mew327/Micah-s-Audio-Transceiver/README.md

# Micah-s-Audio-Transceiver
Low Latency RF Transceiver
