mew327/Micah-s-Audio-Transceiver/Antenna_Candidate_1/CC2430DB_PCB_1_3/Inverted_F_Antenna.dxf

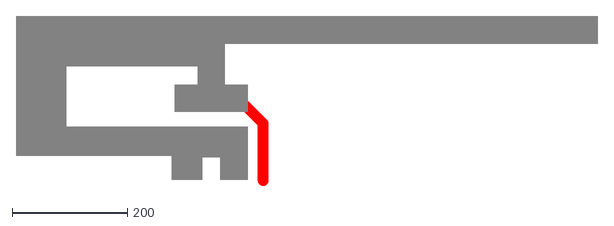
[picture p1: CAD file, 2026-10-24]
Antenna_Candidate_1/CC2430DB_PCB_1_3/Inverted_F_Antenna.dxf
1008.0 x 294.0
