mew327/Micah-s-Audio-Transceiver/Receiver_Enclosure_3d_Print/Receiver_Enclosure_Draft.3mf

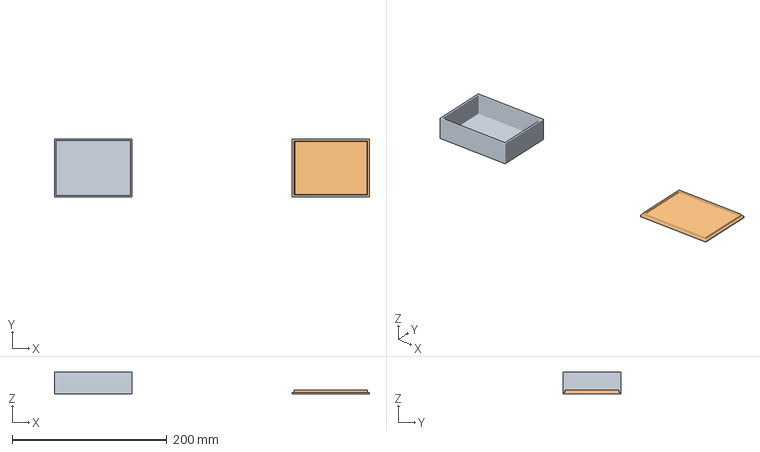
[picture p2: CAD file, 2026-10-24]
Receiver_Enclosure_3d_Print/Receiver_Enclosure_Draft.3mf
407.2 x 75.0 x 28.0 mm
receiver_base.stl
receiver_lid.stl
