mew327/Micah-s-Audio-Transceiver/Receiver_Enclosure_3d_Print/receiver_base.3mf

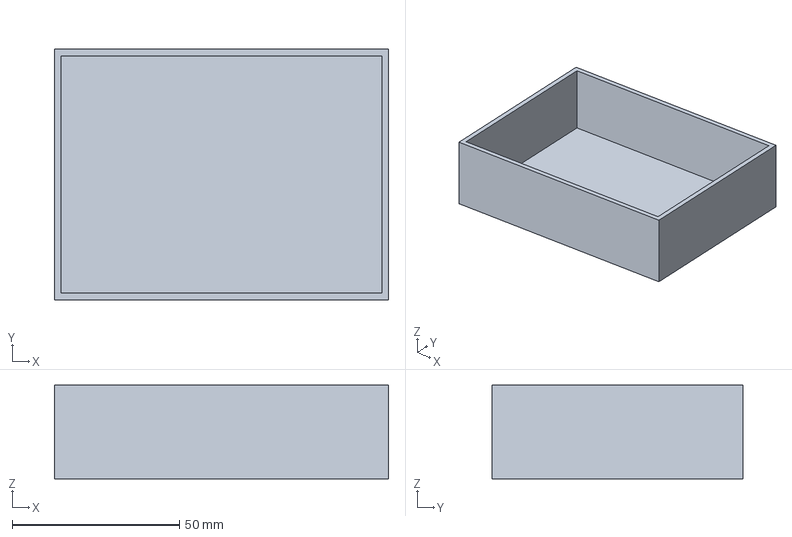
[picture p3: CAD file, 2026-10-24]
Receiver_Enclosure_3d_Print/receiver_base.3mf
100.0 x 75.0 x 28.0 mm
