mew327/Micah-s-Audio-Transceiver/(list of files, cad)

Other CAD files:
Receiver_Enclosure_3d_Print/receiver_base.stl
Receiver_Enclosure_3d_Print/receiver_lid.stl
