mew327/Micah-s-Audio-Transceiver/Guitar_Transceiver/Guitar_Receiver.kicad_pcb

## KiCad design Guitar_Transceiver/Guitar_Receiver.kicad_pcb (2026-11-04)

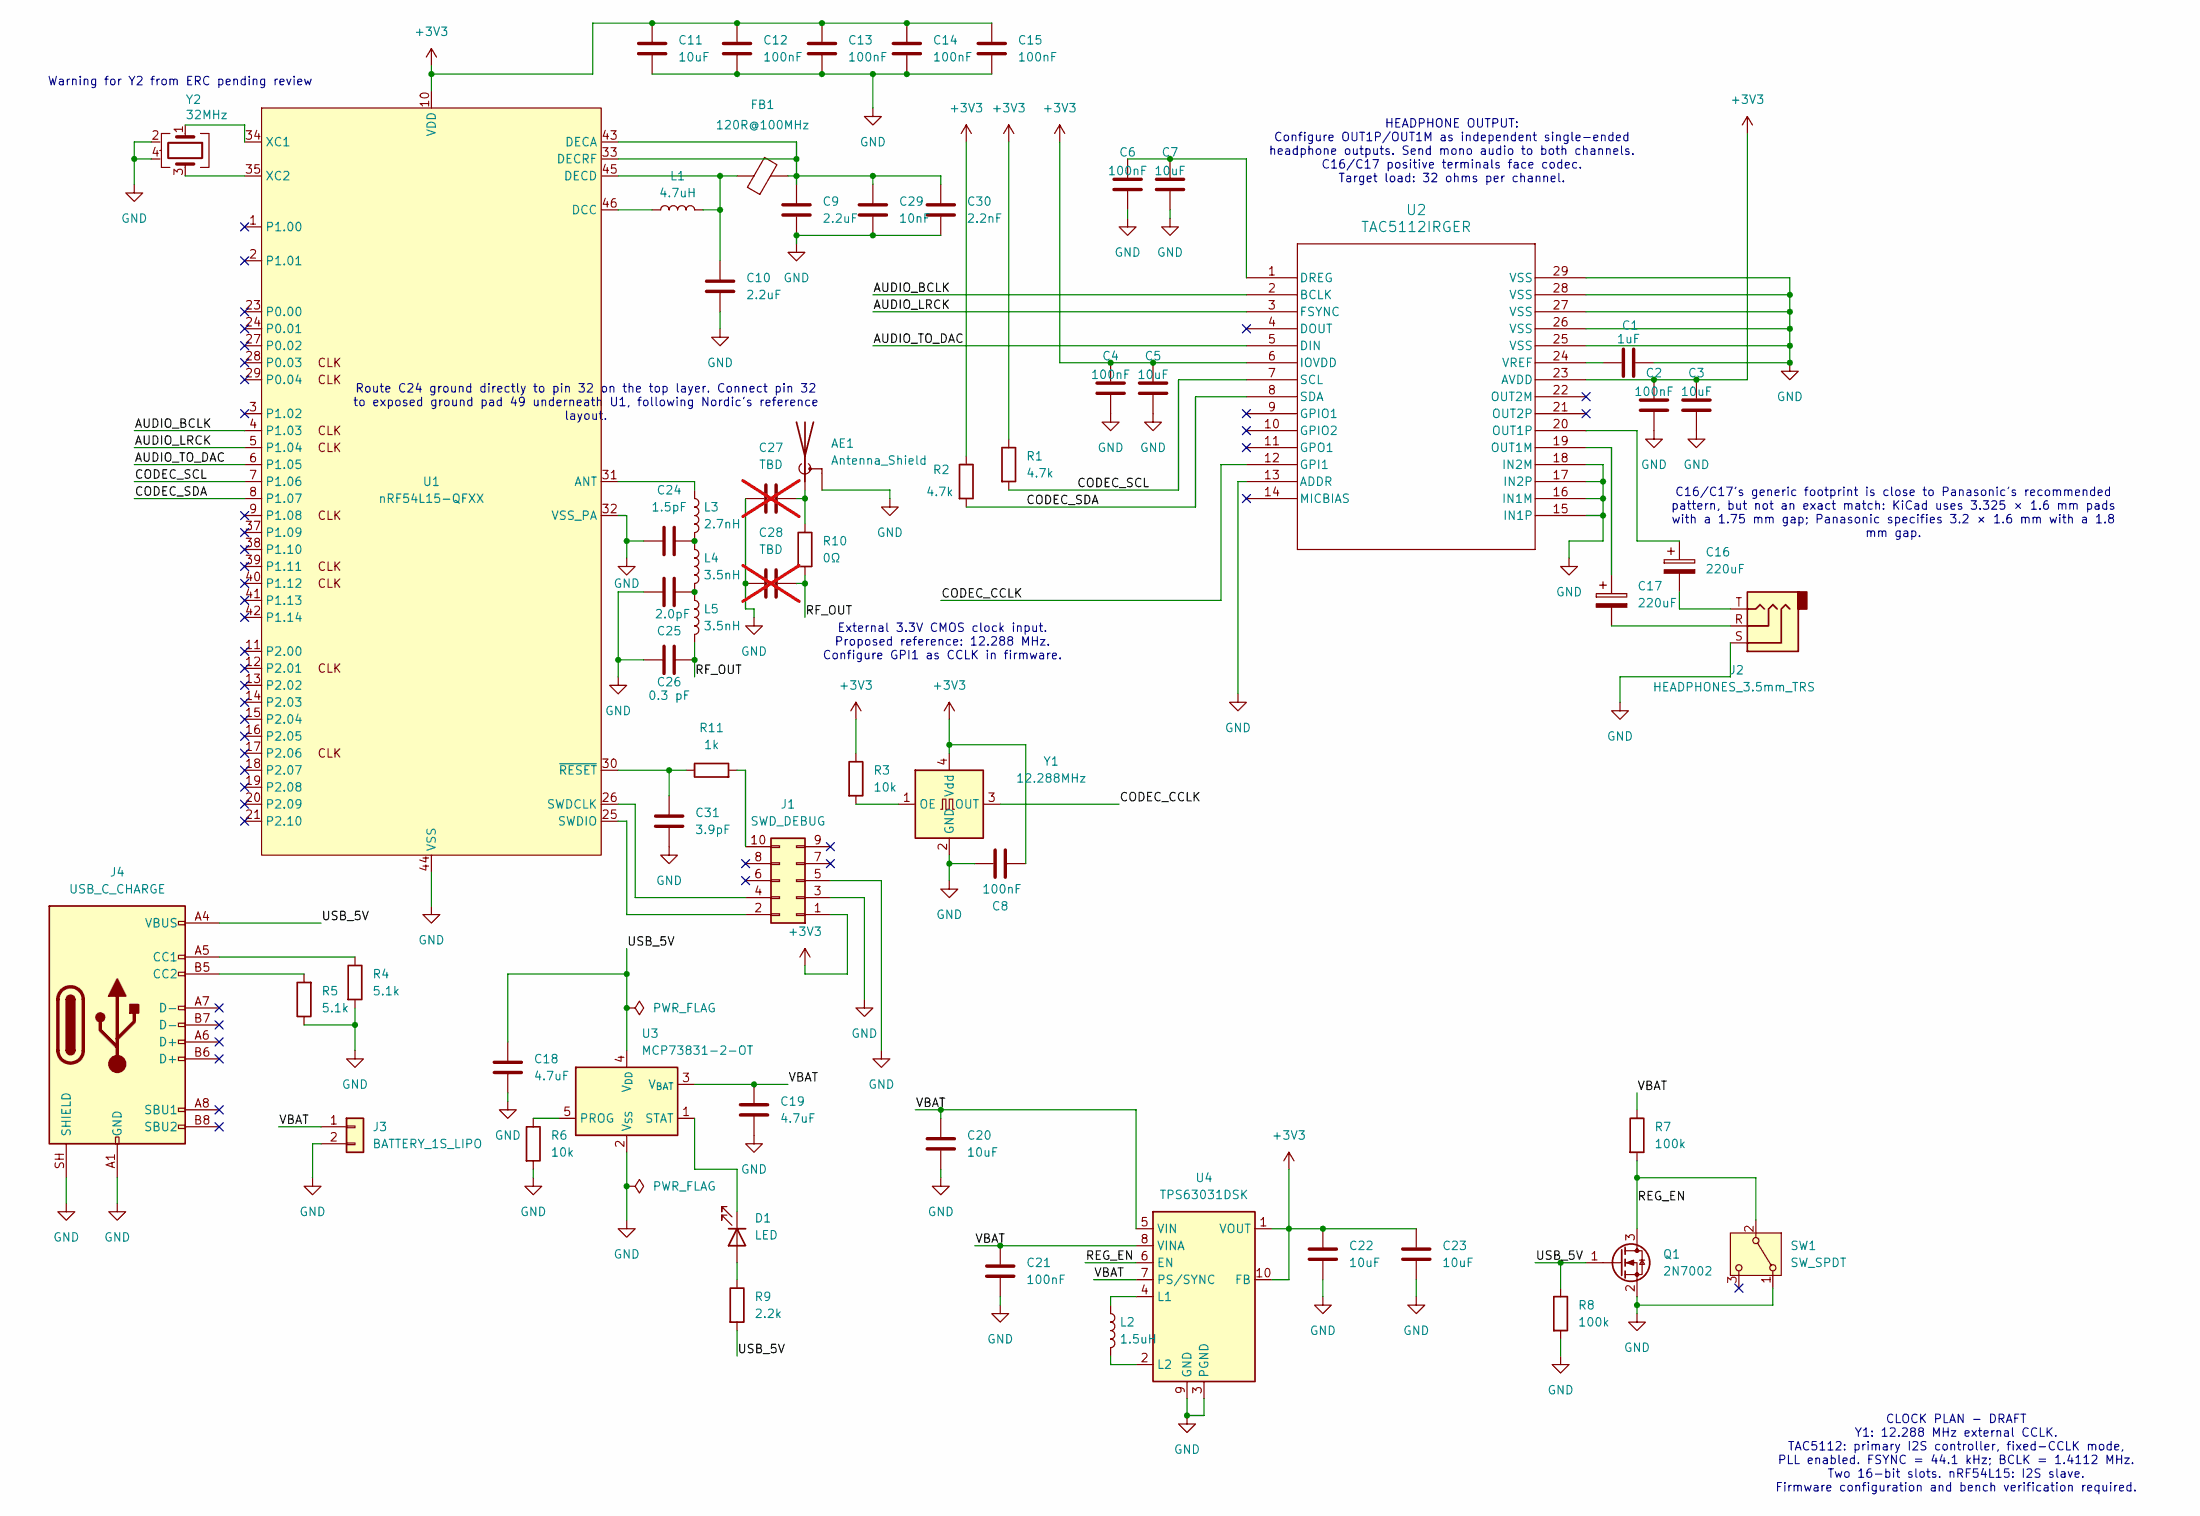
[picture p5: schematic Guitar_Receiver.kicad_sch]

Parts:
AE1: Antenna_Shield; IFA_SWRU120D_Copper_Draft
C1: 1uF; C_0603_1608Metric; Voltage Rating 10V
C2, C4, C6: 100nF; C_0603_1608Metric; Voltage Rating 10V
C3, C5, C7: 10uF; C_0805_2012Metric; Voltage Rating 10V
C8: 100nF; C_0603_1608Metric; Voltage Rating 10V; Tolerance ±10%
C9, C10: 2.2uF; C_0201_0603Metric; Voltage Rating 2.5V; Tolerance ±20%
C11: 10uF; C_0402_1005Metric; Voltage Rating 6.3V; Tolerance ±20%
C12, C13, C14, C15: 100nF; C_0201_0603Metric; Voltage Rating 6.3V; Tolerance ±10%
C16, C17: 220uF; C_Elec_6.3x5.8; Voltage Rating 6.3V; Tolerance ±20%; MPN EEEFP0J221AP
C18, C19: 4.7uF; C_0603_1608Metric; Voltage Rating 10V
C20, C22, C23: 10uF; C_0805_2012Metric; Voltage Rating 10 V
C21: 100nF; C_0603_1608Metric; Voltage Rating 10 V
C24: 1.5pF; C_0201_0603Metric; Tolerance ±0.05 pF; Voltage Rating ≥25 V
C25: 2.0pF; C_0201_0603Metric; Tolerance ±0.05 pF; Voltage Rating ≥25 V
C26: 0.3 pF; C_0201_0603Metric; Tolerance ±0.1 pF; Voltage Rating 50 V
C27, C28: TBD; C_0201_0603Metric; Voltage Rating ≥25 V; not fitted
C29: 10nF; C_0201_0603Metric; Tolerance ±10%; Voltage Rating ≥6.3 V
C30: 2.2nF; C_0201_0603Metric; Tolerance ±10%; Voltage Rating ≥10 V
C31: 3.9pF; C_0201_0603Metric; Tolerance ±0.25 pF; Voltage Rating 50 V
D1: LED; LED_0603_1608Metric; MPN APT1608SURCK
FB1: 120R@100MHz; L_0201_0603Metric; Current Rating 200 mA; MPN BLM03AG121SN1D
J1: SWD_DEBUG; PinHeader_2x05_P1.27mm_Vertical
J2: HEADPHONES_3.5mm_TRS; Jack_3.5mm_CUI_SJ1-3523N_Horizontal; MPN SJ1-3523N
J3: BATTERY_1S_LIPO; JST_PH_B2B-PH-K_1x02_P2.00mm_Vertical; MPN B2B-PH-K-S(LF)(SN)
J4: USB_C_CHARGE; USB_C_Receptacle_GCT_USB4105-xx-A_16P_TopMnt_Horizontal; MPN USB4105-GF-A
L1: 4.7uH; L_0603_1608Metric; Tolerance ±20%; Current Rating >120 mA
L2: 1.5uH; L_Coilcraft_LPS3015_3.0x3.0mm; Tolerance ±20%; MPN LPS3015-152MRC
L3: 2.7nH; L_0201_0603Metric; Tolerance ±0.1 nH; Current Rating ≥600 mA
L4, L5: 3.5nH; L_0201_0603Metric; Tolerance ±0.1 nH; Current Rating ≥500 mA
Q1: 2N7002; SOT-23
R1, R2: 4.7k; R_0603_1608Metric
R3, R6: 10k; R_0603_1608Metric
R4, R5: 5.1k; R_0603_1608Metric; Tolerance ±1%
R7, R8: 100k; R_0603_1608Metric
R9: 2.2k; R_0603_1608Metric
R10: 0Ω; R_0201_0603Metric
R11: 1k; R_0201_0603Metric
SW1: SW_SPDT; SW_SPDT_CK_JS102011SAQN; MPN JS102011SAQN
U1: nRF54L15-QFXX; QFN-48-1EP_6x6mm_P0.4mm_EP4.6x4.6mm_ThermalVias; MPN NRF54L15-QFAA-R
U2: TAC5112IRGER; TAC5112_RGE0024R_TI_Example_Candidate; MPN TAC5112IRGER
U3: MCP73831-2-OT; SOT-23-5
U4: TPS63031DSK; TPS63031_DSK0010A_TI_Example_Candidate
Y1: 12.288MHz; Oscillator_SMD_SiT_PQFN-4Pin_3.2x2.5mm; MPN SiT8008BC-22-33E-12.288000G
Y2: 32MHz; Crystal_SMD_2016-4Pin_2.0x1.6mm; MPN CX2016DB32000D0FLJCC

Connections:
+3V3: C2.1, C3.1, C4.1, C5.1, C8.2, C11.1, C12.1, C13.1, C14.1, C15.1, C22.1, C23.1, J1.1, R1.1, R2.1, R3.1, U1.10 (VDD), U1.22 (VDD), U1.36 (VDD), U1.47 (VDD), U1.48 (VDD), U2.6 (IOVDD), U2.23 (AVDD), U4.1 (VOUT), U4.10 (FB), Y1.4 (Vdd)
/AUDIO_BCLK: U1.4 (P1.03), U2.2 (BCLK)
/AUDIO_LRCK: U1.5 (P1.04), U2.3 (FSYNC)
/AUDIO_TO_DAC: U1.6 (P1.05), U2.5 (DIN)
/CODEC_CCLK: U2.12 (GPI1), Y1.3 (OUT)
/CODEC_SCL: R1.2, U1.7 (P1.06), U2.7 (SCL)
/CODEC_SDA: R2.2, U1.8 (P1.07), U2.8 (SDA)
/REG_EN: Q1.3 (D), R7.2, SW1.2 (B), U4.6 (EN)
/RF_OUT: C26.2, C28.2, L5.2, R10.2
/USB_5V: C18.2, J4.A4 (VBUS), J4.A9 (VBUS), J4.B4 (VBUS), J4.B9 (VBUS), Q1.1 (G), R8.1, R9.2, U3.4 (V_{DD})
/VBAT: C19.2, C20.1, C21.1, J3.1, R7.1, U3.3 (V_{BAT}), U4.5 (VIN), U4.7 (PS/SYNC), U4.8 (VINA)
GND: AE1.2 (Shield), C1.2, C2.2, C3.2, C4.2, C5.2, C6.2, C7.2, C8.1, C9.2, C10.2, C11.2, C12.2, C13.2, C14.2, C15.2, C18.1, C19.1, C20.2, C21.2, C22.2, C23.2, C24.1, C25.1, C26.1, C27.1, C28.1, C29.2, C30.2, C31.2, J1.3, J1.5, J2.S, J3.2, J4.A1 (GND), J4.A12 (GND), J4.B1 (GND), J4.B12 (GND), J4.SH (SHIELD), Q1.2 (S), R4.2, R5.1, R6.2, R8.2, SW1.1 (A), U1.32 (VSS_PA), U1.44 (VSS), U1.49 (VSS), U2.13 (ADDR), U2.15 (IN1P), U2.16 (IN1M), U2.17 (IN2P), U2.18 (IN2M), U2.25 (VSS), U2.26 (VSS), U2.27 (VSS), U2.28 (VSS), U2.29 (VSS), U3.2 (V_{SS}), U4.3 (PGND), U4.9 (GND), U4.11 (PGND), Y1.2 (GND), Y2.2 (G), Y2.4 (G)
unnamed: AE1.1 (A), C27.2, R10.1
unnamed: C16.2, J2.T
unnamed: C17.2, J2.R
unnamed: C24.2, L3.2, L4.1
unnamed: C25.2, L4.2, L5.1
unnamed: D1.2 (A), R9.1
unnamed: D1.1 (K), U3.1 (STAT)
unnamed: J1.2, U1.25 (SWDIO)
unnamed: J1.4, U1.26 (SWDCLK)
unnamed: J1.10, R11.2
unnamed: J4.A5 (CC1), R4.1
unnamed: J4.B5 (CC2), R5.2
unnamed: L3.1, U1.31 (ANT)
unnamed: L1.1, U1.46 (DCC)
unnamed: C9.1, C29.1, C30.1, FB1.2, U1.33 (DECRF), U1.43 (DECA)
unnamed: C10.1, FB1.1, L1.2, U1.45 (DECD)
unnamed: U1.34 (XC1), Y2.1
unnamed: U1.35 (XC2), Y2.3
unnamed: C31.1, R11.1, U1.30 (~RESET)
unnamed: C6.1, C7.1, U2.1 (DREG)
unnamed: C17.1, U2.19 (OUT1M)
unnamed: C16.1, U2.20 (OUT1P)
unnamed: C1.1, U2.24 (VREF)
unnamed: R6.1, U3.5 (PROG)
unnamed: L2.1, U4.4 (L1)
unnamed: L2.2, U4.2 (L2)
unnamed: R3.2, Y1.1 (OE)

Notes on the sheet:
HEADPHONE OUTPUT: Configure OUT1P/OUT1M as independent single-ended headphone outputs. Send mono audio to both channels. C16/C17 positive terminals face codec. Target load: 32 ohms per channel.
External 3.3V CMOS clock input. Proposed reference: 12.288 MHz. Configure GPI1 as CCLK in firmware.
CLOCK PLAN - DRAFT Y1: 12.288 MHz external CCLK. TAC5112: primary I2S controller, fixed-CCLK mode, PLL enabled. FSYNC = 44.1 kHz; BCLK = 1.4112 MHz. Two 16-bit slots. nRF54L15: I2S slave. Firmware configuration and bench verification required.
C16/C17's generic footprint is close to Panasonic's recommended pattern, but not an exact match: KiCad uses 3.325 × 1.6 mm pads with a 1.75 mm gap; Panasonic specifies 3.2 × 1.6 mm with a 1.8 mm gap.
Route C24 ground directly to pin 32 on the top layer. Connect pin 32 to exposed ground pad 49 underneath U1, following Nordic's reference layout.
Warning for Y2 from ERC pending review

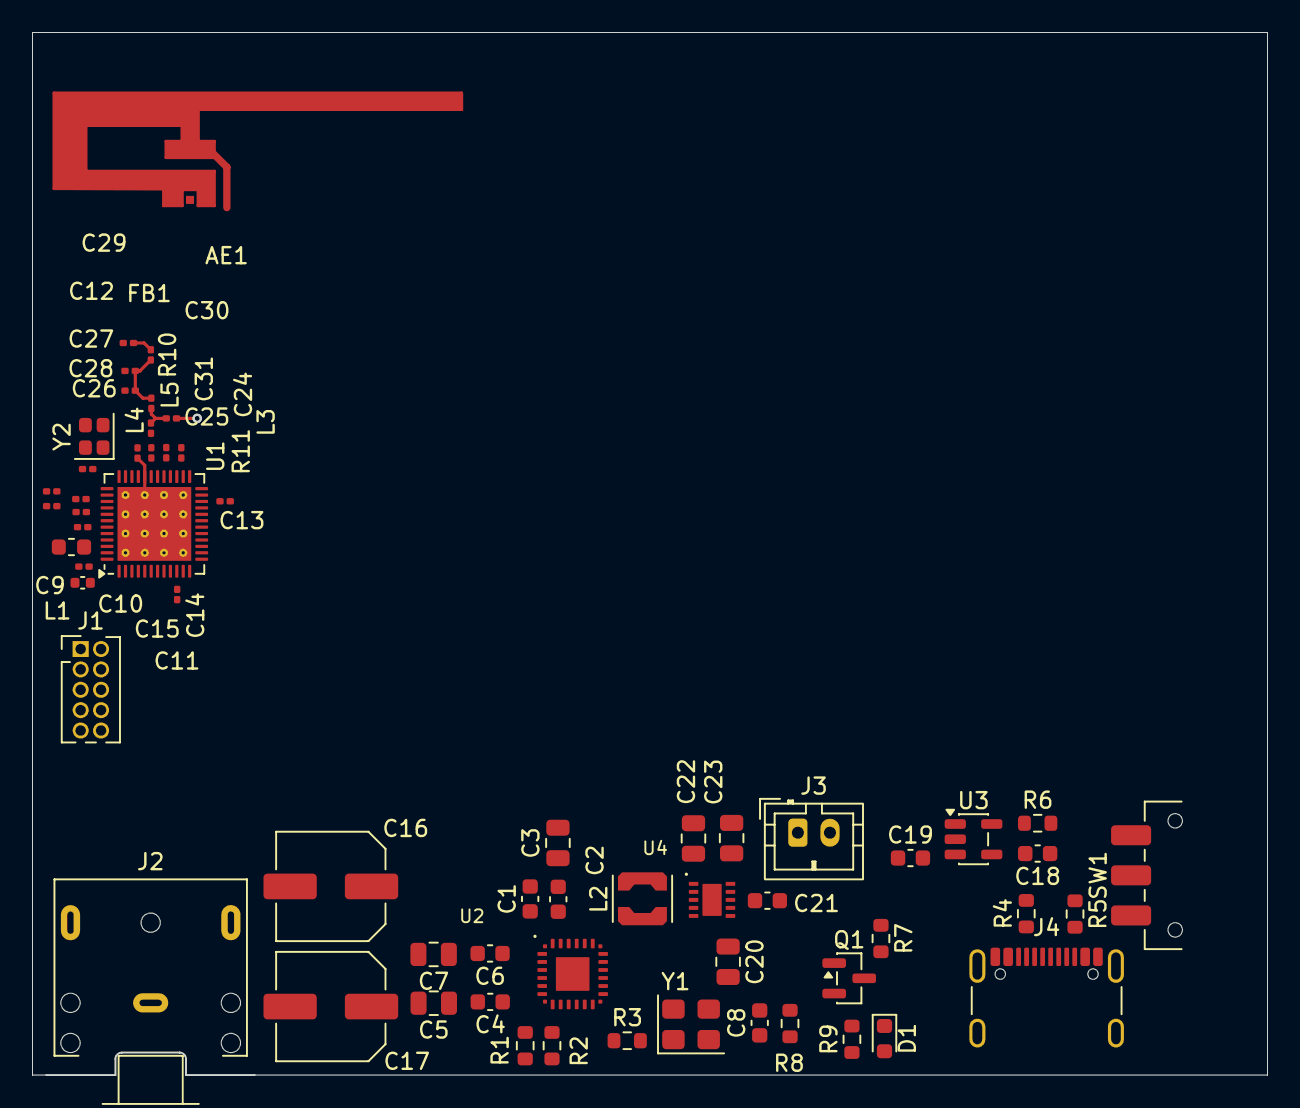
[picture p6: board Guitar_Receiver.kicad_pcb from above]

Board: 4 copper layers, 77.0 x 65.0 mm, 62 parts (0 on the bottom side), 39 nets.
