mew327/Micah-s-Audio-Transceiver/(commit log)

2026-10-17 begin kicad files
    [Guitar_Receiver.kicad_pcb, Guitar_Receiver.kicad_sch]
2026-10-17 Update project files
    [Guitar_Receiver.kicad_sch]
2026-10-17 update files
    [Guitar_Receiver.kicad_sch]
